evolutek/can-usb-dongle/hardware/Mapping STM32.PNG

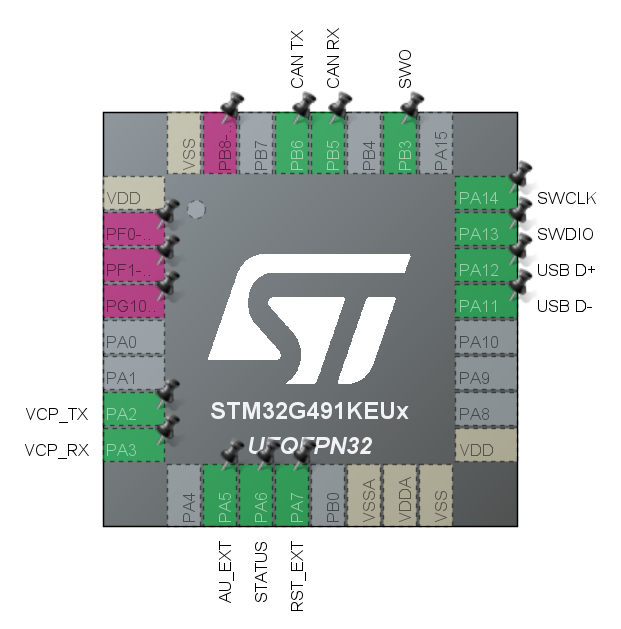
hardware/Mapping STM32.PNG
