evolutek/can-usb-dongle/hardware/Output/Board-Front.pdf

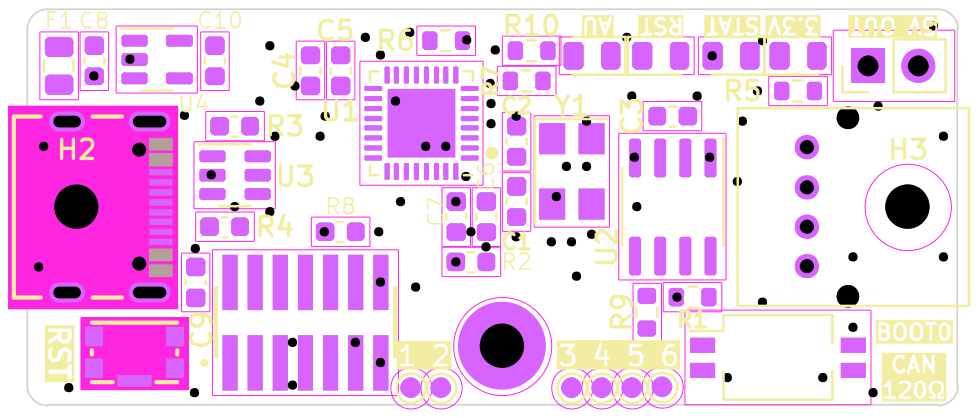
[picture p2: page 1]
