evolutek/can-usb-dongle/hardware/Output/Schematics.pdf

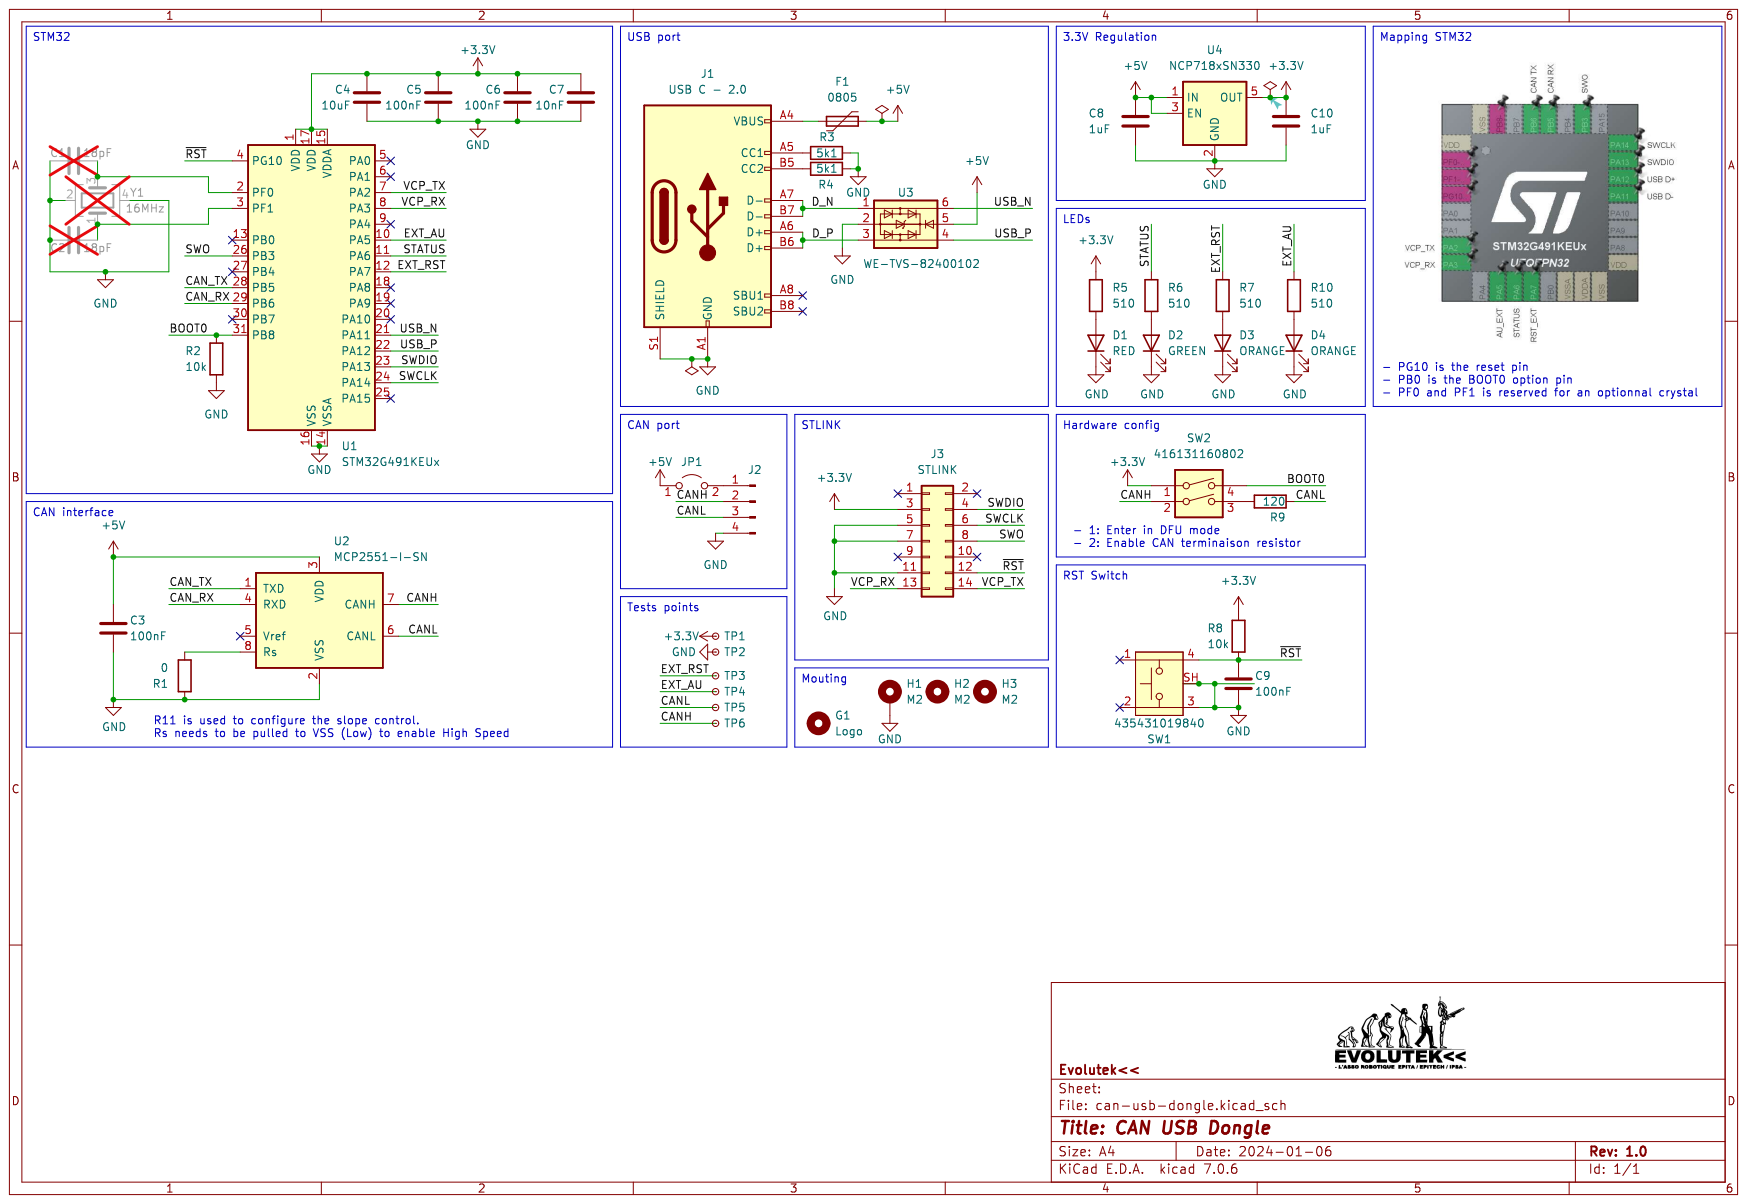
[picture p3: page 1]
