evolutek/can-usb-dongle/hardware/can-usb-dongle.kicad_pcb

## KiCad design hardware/can-usb-dongle.kicad_pcb (2024-01-08)

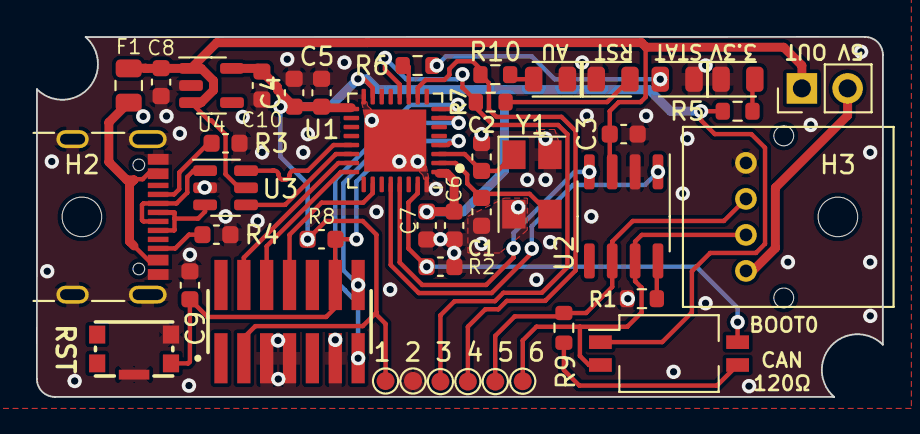
[picture p4: board can-usb-dongle.kicad_pcb from above]

Board: 2 copper layers, 47.0 x 20.0 mm, 45 parts (1 on the bottom side), 33 nets.

Parts:
C1, C2: 18pF; C_0603_1608Metric
C3, C5, C6, C9: 100nF; C_0603_1608Metric
C4: 10uF; C_0603_1608Metric
C7: 10nF; C_0603_1608Metric
C8, C10: 1uF; C_0603_1608Metric
D1: RED; LED_0805_2012Metric
D2: GREEN; LED_0805_2012Metric
D3, D4: ORANGE; LED_0805_2012Metric
F1: 0805; C_0805_2012Metric
G1: Logo; logo-evo-min
H2, H3: M2; MountingHole_2.2mm_M2_ISO14580
J1: USB C - 2.0; USB_C_Receptacle_GCT_USB4105-xx-A_16P_TopMnt_Horizontal
J2: Conn_01x04_Pin; S04B-PASK
J3: STLINK; SAMTEC_FTSH-107-01-L-DV-K
JP1: Power selector; PinHeader_1x02_P2.54mm_Vertical
R1: 0; R_0603_1608Metric
R2, R8: 10k; C_0603_1608Metric
R3, R4: 5k1; C_0603_1608Metric
R5, R6, R7, R10: 510; R_0603_1608Metric
R9: 120; R_0603_1608Metric
SW1: 435431019840
SW2: 416131160802; SW_DIP_SPSTx02_Slide_KingTek_DSHP02TS_W7.62mm_P1.27mm
TP1, TP2, TP3, TP4, TP5, TP6: TestPoint_Small; TestPoint_Pad_D1.0mm
U1: STM32G491KEUx; QFN-32-1EP_5x5mm_P0.5mm_EP3.45x3.45mm
U2: MCP2551-I-SN; SOIC-8_3.9x4.9mm_P1.27mm
U3: WE-TVS-82400102; SOT-23-6
U4: NCP718xSN330; SOT-23-5
Y1: 16MHz; Crystal_SMD_5032-4Pin_5.0x3.2mm

Connections:
+3.3V: C4.1, C5.1, C6.1, C7.1, C10.1, J3.3, R5.2, R8.2, SW2.1, TP1.1, U1.1 (VDD), U1.15 (VDDA), U1.17 (VDD), U4.5 (OUT)
+5V: C3.1, C8.1, F1.2, JP1.1 (A), U2.3 (VDD), U3.5, U4.1 (IN), U4.3 (EN)
/BOOT0: R2.2, SW2.4, U1.31 (PB8)
/CANH: J2.2, SW2.2, TP6.1, U2.7 (CANH)
/CANL: J2.3, R9.1, TP5.1, U2.6 (CANL)
/CAN_RX: U1.29 (PB6), U2.4 (RXD)
/CAN_TX: U1.28 (PB5), U2.1 (TXD)
/D_N: J1.A7 (D-), J1.B7 (D-), U3.1
/D_P: J1.A6 (D+), J1.B6 (D+), U3.3
/EXT_AU: R10.2, TP4.1, U1.10 (PA5)
/EXT_RST: R7.2, TP3.1, U1.12 (PA7)
/STATUS: R6.2, U1.11 (PA6)
/SWCLK: J3.6, U1.24 (PA14)
/SWDIO: J3.4, U1.23 (PA13)
/SWO: J3.8, U1.26 (PB3)
/USB_N: U1.21 (PA11), U3.6
/USB_P: U1.22 (PA12), U3.4
/VCP_RX: J3.13, U1.8 (PA3)
/VCP_TX: J3.14, U1.7 (PA2)
/~RST: C9.1, J3.12, R8.1, SW1.4, U1.4 (PG10)
GND: C1.2, C2.2, C3.2, C4.2, C5.2, C6.2, C7.2, C8.2, C9.2, C10.2, D1.1 (K), D2.1 (K), D3.1 (K), D4.1 (K), J1.A1 (GND), J1.A12 (GND), J1.B1 (GND), J1.B12 (GND), J1.S1 (SHIELD), J2.4, J3.5, J3.7, J3.11, R1.2, R2.1, R3.2, R4.1, SW1.3, SW1.SH, TP2.1, U1.14 (VSSA), U1.16 (VSS), U1.32 (VSS), U1.33 (VSS), U2.2 (VSS), U3.2, U4.2 (GND), Y1.2, Y1.4
unnamed: D1.2 (A), R5.1
unnamed: D2.2 (A), R6.1
unnamed: D3.2 (A), R7.1
unnamed: D4.2 (A), R10.1
unnamed: F1.1, J1.A4 (VBUS), J1.A9 (VBUS), J1.B4 (VBUS), J1.B9 (VBUS)
unnamed: J1.A5 (CC1), R3.1
unnamed: J1.B5 (CC2), R4.2
unnamed: J2.1, JP1.2 (B)
unnamed: R9.2, SW2.3
unnamed: C1.1, U1.2 (PF0), Y1.3
unnamed: C2.1, U1.3 (PF1), Y1.1
unnamed: R1.1, U2.8 (Rs)
