evolutek/can-usb-dongle/firmware/firmware.ioc

Mcu.UserName=STM32G491KEUx
PA11.GPIO_Label=USB D-
PA11.Signal=USB_DM
PA12.GPIO_Label=USB D+
PA12.Signal=USB_DP
PA13.GPIO_Label=SWDIO
PA13.Signal=SYS_JTMS-SWDIO
PA14.GPIO_Label=SWCLK 
PA14.Signal=SYS_JTCK-SWCLK
PA2.GPIO_Label=VCP_TX
PA2.Signal=USART2_TX
PA3.GPIO_Label=VCP_RX
PA3.Signal=USART2_RX
PA5.GPIO_Label=AU_EXT
PA5.Signal=GPIO_Output
PA6.GPIO_Label=STATUS
PA6.Signal=GPIO_Output
PA7.GPIO_Label=RST_EXT
PA7.Signal=GPIO_Output
PB3.GPIO_Label=SWO
PB3.Signal=SYS_JTDO-SWO
PB5.GPIO_Label=CAN RX 
PB5.Signal=FDCAN2_RX
PB6.GPIO_Label=CAN TX
PB6.Signal=FDCAN2_TX
