evolutek/can-usb-dongle/firmware/Core/Inc/main.h

#define VCP_TX_Pin GPIO_PIN_2
#define VCP_TX_GPIO_Port GPIOA
#define VCP_RX_Pin GPIO_PIN_3
#define VCP_RX_GPIO_Port GPIOA
#define AU_EXT_Pin GPIO_PIN_5
#define AU_EXT_GPIO_Port GPIOA
#define STATUS_Pin GPIO_PIN_6
#define STATUS_GPIO_Port GPIOA
#define RST_EXT_Pin GPIO_PIN_7
#define RST_EXT_GPIO_Port GPIOA
#define USB_D__Pin GPIO_PIN_11
#define USB_D__GPIO_Port GPIOA
#define USB_D_A12_Pin GPIO_PIN_12
#define USB_D_A12_GPIO_Port GPIOA
#define SWDIO_Pin GPIO_PIN_13
#define SWDIO_GPIO_Port GPIOA
#define SWCLK_Pin GPIO_PIN_14
#define SWCLK_GPIO_Port GPIOA
#define SWO_Pin GPIO_PIN_3
#define SWO_GPIO_Port GPIOB
#define CAN_RX_Pin GPIO_PIN_5
#define CAN_RX_GPIO_Port GPIOB
#define CAN_TX_Pin GPIO_PIN_6
#define CAN_TX_GPIO_Port GPIOB
