evolutek/can-usb-dongle/(commit log)

2024-01-05 WIP Schematics
    [can-usb-dongle.kicad_pcb, can-usb-dongle.kicad_sch]
2024-01-05 initial schematic
    [can-usb-dongle.kicad_sch]
2024-01-05 little crosses everywhere :)
    [can-usb-dongle.kicad_sch]
2024-01-05 started routing
    [can-usb-dongle.kicad_pcb, can-usb-dongle.kicad_sch]
2024-01-06 board finalized
    [can-usb-dongle.kicad_pcb, can-usb-dongle.kicad_sch]
2024-01-06 minor fix
    [can-usb-dongle.kicad_pcb]
2024-01-06 CAN USB Dongle V1.0
    [can-usb-dongle.kicad_pcb, can-usb-dongle.kicad_sch]
2024-01-07 fixed the usb - c connector
    [can-usb-dongle.kicad_pcb]
2024-01-07 changed the usb footprint
    [can-usb-dongle.kicad_sch]
2024-01-07 Fix gerber files
    [can-usb-dongle-B_Cu.gbr, can-usb-dongle-B_Mask.gbr, can-usb-dongle-B_Paste.gbr, can-usb-dongle-B_Silkscreen.gbr, can-usb-dongle-Edge_Cuts.gbr, can-usb-dongle-F_Cu.gbr, can-usb-dongle-F_Mask.gbr, can-usb-dongle-F_Paste.gbr]
2024-01-08 reworked mounting solution
    [can-usb-dongle.kicad_pcb, can-usb-dongle.kicad_sch]
2025-05-25 add config.h + begin CAN driver impl
2025-09-25 begin usb driver implem | TODO fix build errors + add can/usb conversions + define usb package format
    [can_com.c, can_com.h, can_setup.h]
